craigyjp/MFOS-16-Stage-programmable-Phaser/Schematics/Phaser_programmer.pdf

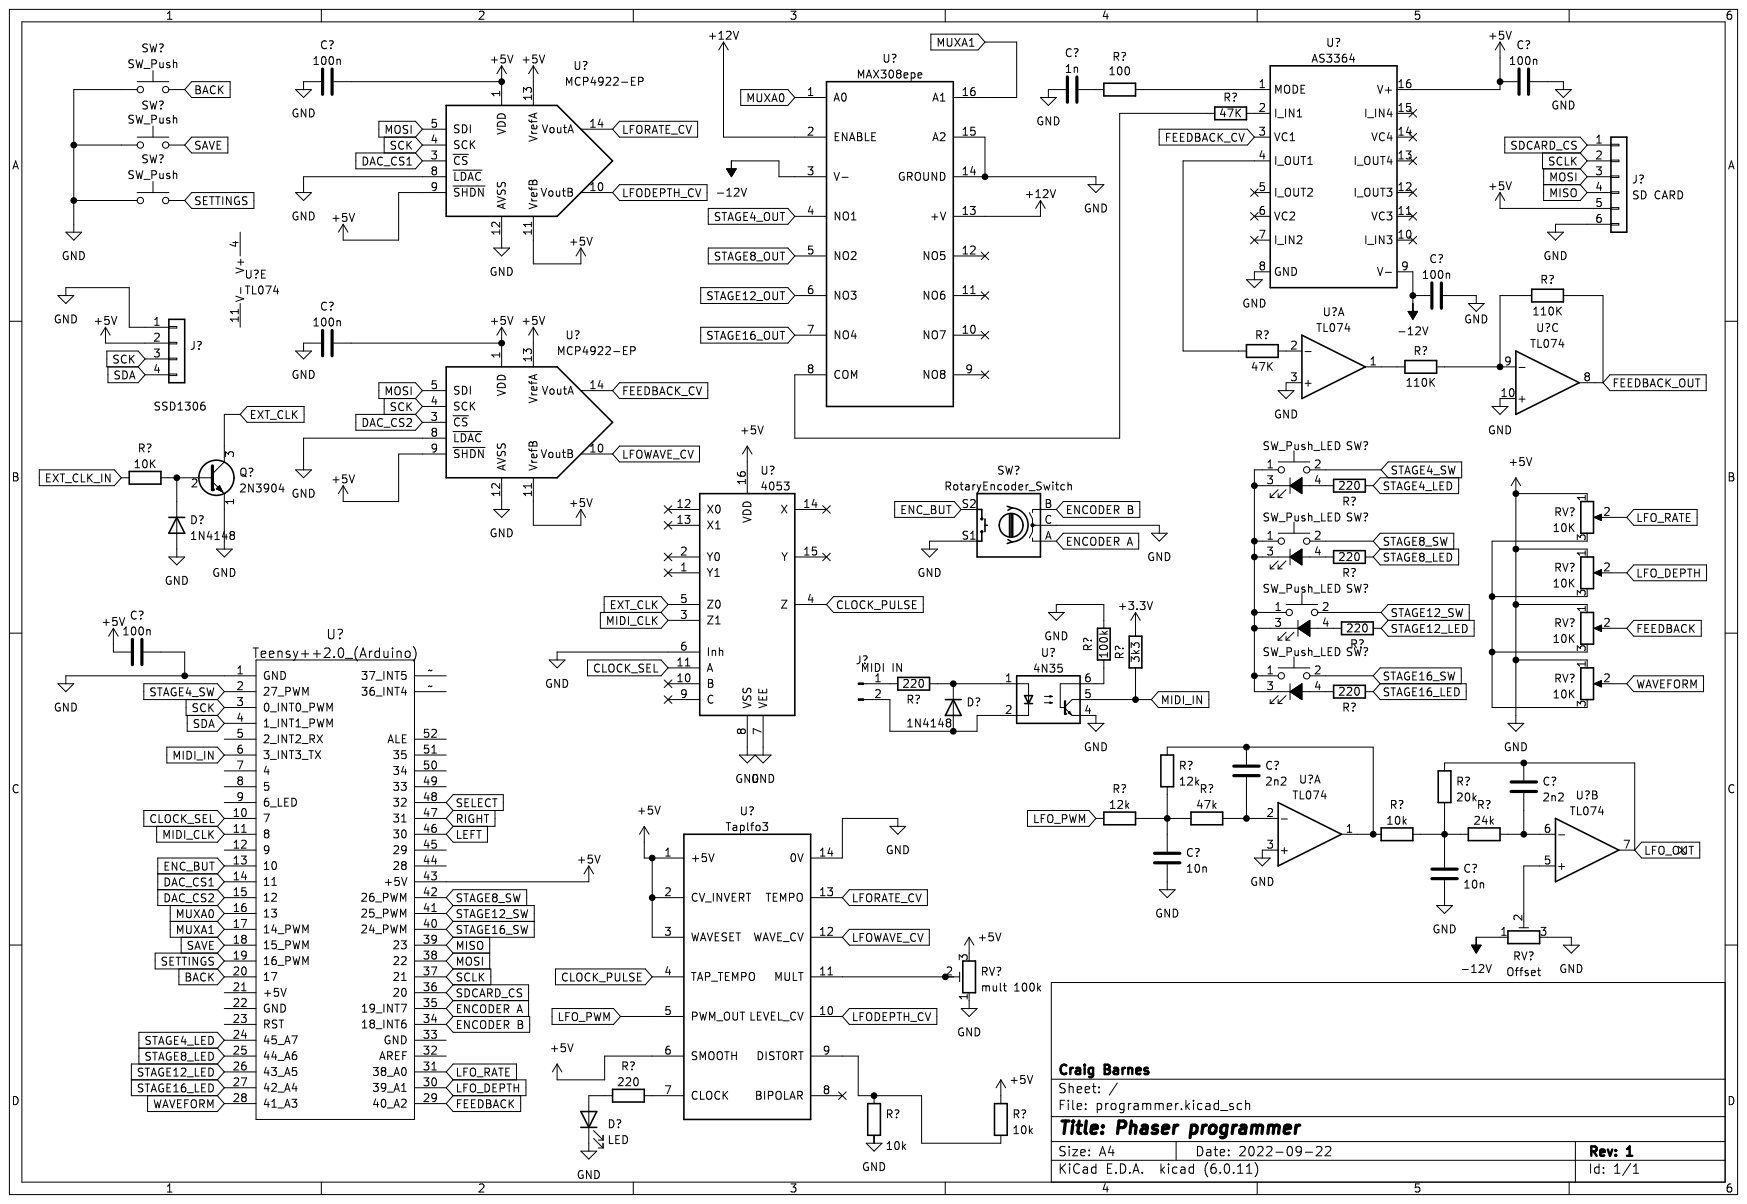
[picture p2: page 1]
