craigyjp/MFOS-16-Stage-programmable-Phaser/(commit log)

2023-05-12 Version 1.1 with button fixes
    [EepromMgr.h, HWControls.h, Parameters.h, Phaser.ino, Settings.h]
2023-05-12 Added schematics initial draft
2023-05-12 Moved encoder to interrupt pins
